opentrng/ptrng/hardware/config/registers/regmap.md

# PTRNG register map

Created with [Corsair](https://github.com/esynr3z/corsair) v1.0.4.

## Conventions

| Access mode | Description |
| :--- | :--- |
| rw | Read and Write |
| rw1c | Read and Write 1 to Clear |
| rw1s | Read and Write 1 to Set |
| ro | Read Only |
| roc | Read Only to Clear |
| roll | Read Only / Latch Low |
| rolh | Read Only / Latch High |
| wo | Write only |
| wosc | Write Only / Self Clear |

## Register map summary

Base address: 0x00000000

| Name | Address | Description |
| :--- | :--- | :--- |
| [ID](#id) | 0x0000 | OpenTRNG's PTRNG identification register for UID and revision number. |
| [CONTROL](#control) | 0x0004 | Global control register for the OpenTRNG's PTRNG |
| [ANALOG](#analog) | 0x0008 | Control register for analog measurements (temperature and voltage) |
| [RING](#ring) | 0x000c | Ring-oscillator enable register (enable bits are active at '1') |
| [FREQCTRL](#freqctrl) | 0x0010 | Frequency counter control register |
| [FREQVALUE](#freqvalue)  | 0x0014 | Frequency counter register for reading the measured value |
| [FREQDIVIDER](#freqdivider) | 0x0018 | Clock divider register, applies on oscillator RO0 |
| [MONITORING](#monitoring) | 0x001c | Register for monitoring the total failure alarm and the online tests |
| [ALARM](#alarm) | 0x0020 | Register for configuring the total failure alarm |
| [ONLINETEST](#onlinetest) | 0x0024 | Register for configuring the online test |
| [FIFOCTRL](#fifoctrl) | 0x0028 | Control register for the FIFO, into read the PTRNG random data output |
| [FIFODATA](#fifodata) | 0x002c | Data register for the FIFO to read the PTRNG random data output |

## ID

OpenTRNG's PTRNG identification register for UID and revision number.

Address offset: 0x0000

Reset value: 0x0001cea3

| Name | Bits | Mode | Reset | Description |
| :--- | :--- | :--- | :--- | :--- |
| REV | 31:16  | ro | 0x0001 | Revision number |
| UID | 15:0 | ro | 0xcea3 | Unique ID for OpenTRNG's PTRNG |

Back to [Register map](#register-map-summary).

## CONTROL

Global control register for the OpenTRNG's PTRNG

Address offset: 0x0004

Reset value: 0x00000000

| Name | Bits | Mode | Reset | Description |
| :--- | :--- | :--- | :--- | :--- |
| - | 31:2 | - | 0x0000000  | Reserved |
| CONDITIONING | 1 | rw | 0x0 | Enable or disable the algorithmic post processing to convert RRN to IRN active to '1', bypass at '0' |
| RESET | 0 | wosc | 0x0 | Synchronous reset active to '1' |

Back to [Register map](#register-map-summary).

## ANALOG

Control register for analog measurements (temperature and voltage)

Address offset: 0x0008

Reset value: 0x00000000

| Name | Bits | Mode | Reset | Description |
| :--- | :--- | :--- | :--- | :--- |
| EN | 31 | rw | 0x0 | Enable continuous temperature and voltage measurements |
| - | 30:24  | - | 0x0 | Reserved |
| VOLTAGE | 23:12  | ro | 0x000 | Measured voltage |
| TEMPERATURE | 11:0 | ro | 0x000 | Measured temperature |

Back to [Register map](#register-map-summary).

## RING

Ring-oscillator enable register (enable bits are active at '1')

Address offset: 0x000c

Reset value: 0x00000000

| Name | Bits | Mode | Reset | Description |
| :--- | :--- | :--- | :--- | :--- |
| EN | 31:0 | rw | 0x00000000 | The bit at index _i_ in the bitfield enables the RO number _i_ |

Back to [Register map](#register-map-summary).

## FREQCTRL

Frequency counter control register

Address offset: 0x0010

Reset value: 0x00000000

| Name | Bits | Mode | Reset | Description |
| :--- | :--- | :--- | :--- | :--- |
| OVERFLOW | 31 | ro | 0x0 | Flag set to '1' if an overflow occurred during measurement |
| - | 30:8 | - | 0x00000 | Reserved |
| SELECT | 7:3 | rw | 0x0 | Select the index of the ring-oscillator for frequency measurement |
| DONE | 2 | ro | 0x0 | This field is set to '1' when the measure is done and ready to be read |
| START | 1 | wosc | 0x0 | Write '1' to start the frequency counter measure |
| EN | 0 | rw | 0x0 | Enable the frequency counter (active at '1') |

Back to [Register map](#register-map-summary).

## FREQVALUE

Frequency counter register for reading the measured value

Address offset: 0x0014

Reset value: 0x00000000

| Name | Bits | Mode | Reset | Description |
| :--- | :--- | :--- | :--- | :--- |
| VALUE | 31:0 | ro | 0x00000000 | Measured value (unit in cycles of the system clock) |

Back to [Register map](#register-map-summary).

## FREQDIVIDER

Clock divider register, applies on oscillator RO0

Address offset: 0x0018

Reset value: 0x00000000

| Name | Bits | Mode | Reset | Description |
| :--- | :--- | :--- | :--- | :--- |
| VALUE | 31:0 | rw | 0x00000000 | Clock divider value (1 means no division, 2 division by two, ...) |

Back to [Register map](#register-map-summary).

## MONITORING

Register for monitoring the total failure alarm and the online tests

Address offset: 0x001c

Reset value: 0x00000000

| Name | Bits | Mode | Reset | Description |
| :--- | :--- | :--- | :--- | :--- |
| - | 31:3 | - | 0x0000000  | Reserved |
| CLEAR | 2 | wosc | 0x0 | This signal clears the online test to set the 'valid' signal back to '1' |
| VALID | 1 | ro | 0x0 | This signal is set to '1' when the online test is valid, when it falls to '0' (invalid) it must be manually cleared |
| ALARM | 0 | roc | 0x0 | This signal is triggered to '1' in the event of a total failure alarm, the alarm is cleared on PTRNG reset only |

Back to [Register map](#register-map-summary).

## ALARM

Register for configuring the total failure alarm

Address offset: 0x0020

Reset value: 0x00000000

| Name | Bits | Mode | Reset | Description |
| :--- | :--- | :--- | :--- | :--- |
| THRESHOLD | 31:0 | rw | 0x00000000 | Threshold value for triggering the total failure alarm. The threshold is compared to a counter and the alarm is triggered when the counter becomes greater or equal than the threshold. The counting method depends on the digitizer type (ERO, MURO, COSO...) |

Back to [Register map](#register-map-summary).

## ONLINETEST

Register for configuring the online test

Address offset: 0x0024

Reset value: 0x00000000

| Name | Bits | Mode | Reset | Description |
| :--- | :--- | :--- | :--- | :--- |
| DEVIATION | 31:16  | rw | 0x0000 | Maximum difference between the average expected value and the current internal value for the online test |
| AVERAGE | 15:0 | rw | 0x0000 | Average expected value for the online test internal value |

Back to [Register map](#register-map-summary).

## FIFOCTRL

Control register for the FIFO, into read the PTRNG random data output

Address offset: 0x0028

Reset value: 0x00000000

| Name | Bits | Mode | Reset | Description |
| :--- | :--- | :--- | :--- | :--- |
| - | 31:23  | - | 0x00 | Reserved |
| BURSTSIZE | 22:7 | ro | 0x0000 | Size of a burst (in count of 32bit words) |
| RDBURSTAVAILABLE | 6 | ro | 0x0 | Valid to '1' when a burst is available for read (see BURSTSIZE) |
| ALMOSTFULL | 5 | ro | 0x0 | Almost full flag |
| ALMOSTEMPTY | 4 | ro | 0x0 | Almost empty flag |
| FULL | 3 | ro | 0x0 | Full flag |
| EMPTY | 2 | ro | 0x0 | Empty flag |
| NOPACKING | 1 | rw | 0x0 | When packing is disabled IRN as written as 32-bit words in the FIFO instead of packing their LSB into 32-bit words |
| CLEAR | 0 | wosc | 0x0 | Clear the FIFO |

Back to [Register map](#register-map-summary).

## FIFODATA

Data register for the FIFO to read the PTRNG random data output

Address offset: 0x002c

Reset value: 0x00000000

| Name | Bits | Mode | Reset | Description |
| :--- | :--- | :--- | :--- | :--- |
| DATA | 31:0 | ro | 0x00000000 | 32 bits word from the PTRNG |

Back to [Register map](#register-map-summary).
