opentrng/ptrng/doc/img/coso.png

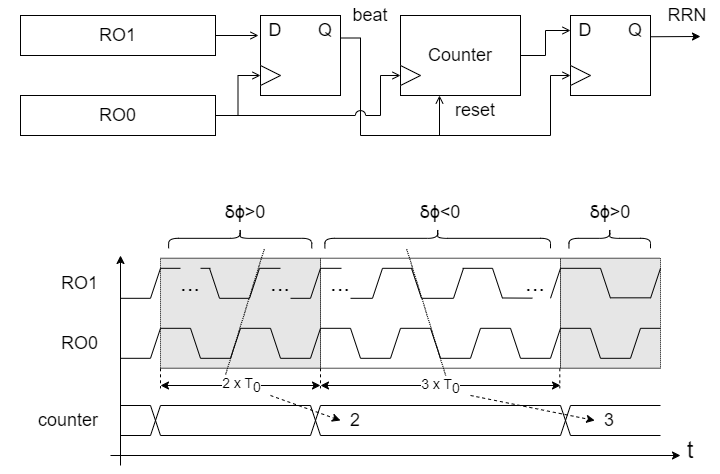
doc/img/coso.png
