opentrng/ptrng/doc/img/ero.png

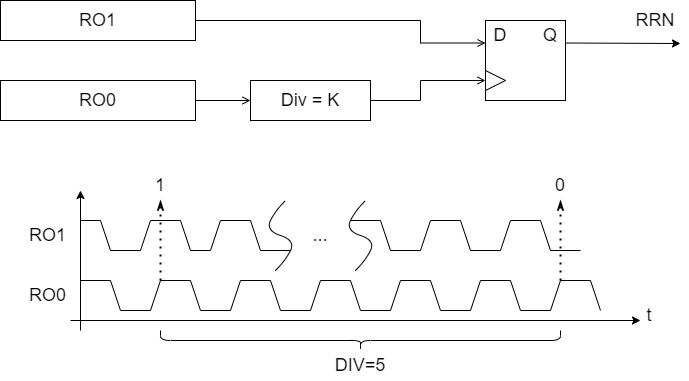
doc/img/ero.png
