opentrng/ptrng/doc/img/muro.png

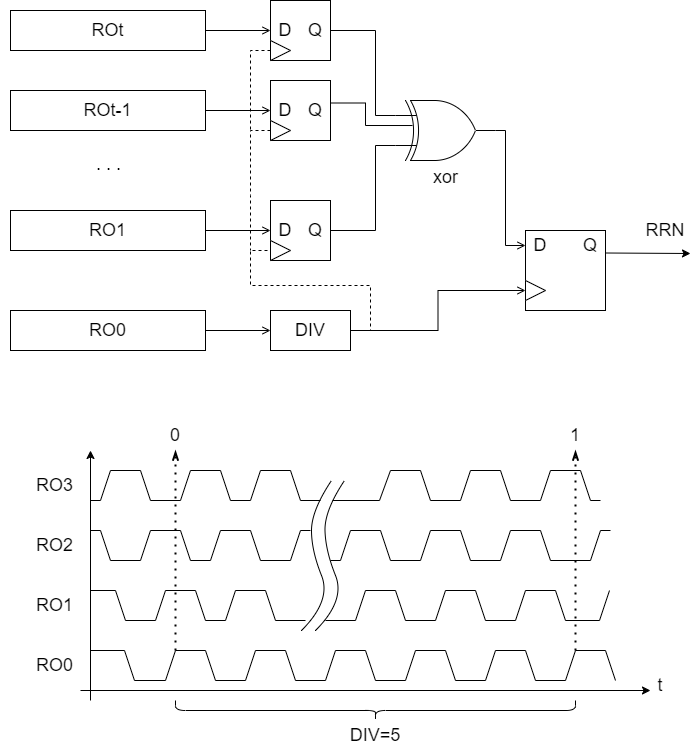
doc/img/muro.png
