opentrng/ptrng/doc/img/ptrng.png

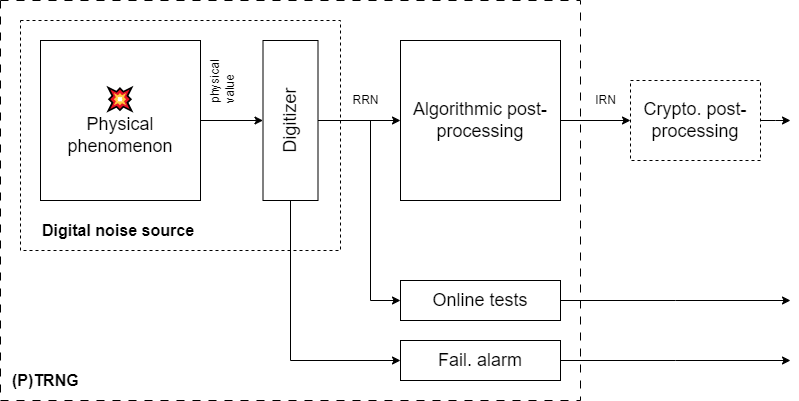
doc/img/ptrng.png
