opentrng/ptrng/doc/img/ringo.png

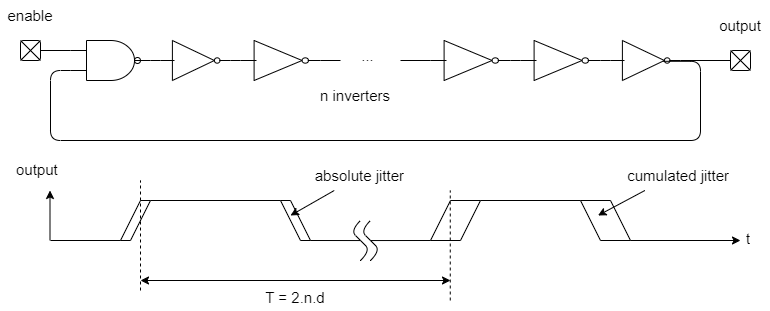
doc/img/ringo.png
