opentrng/ptrng/doc/img/simulation.png

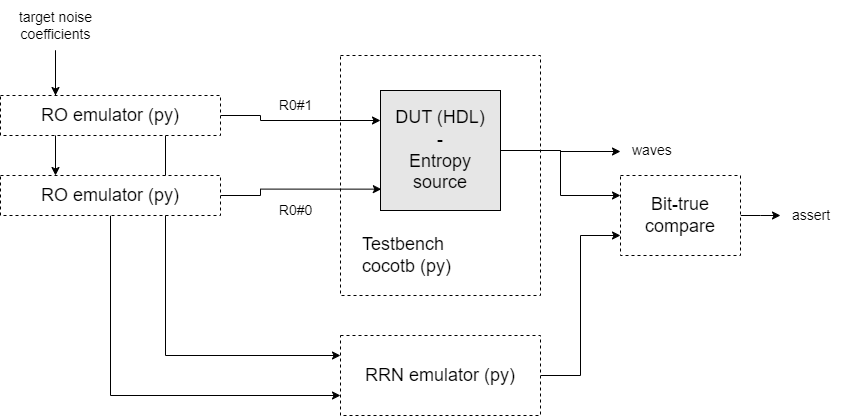
doc/img/simulation.png
