opentrng/ptrng/doc/img/workflow.png

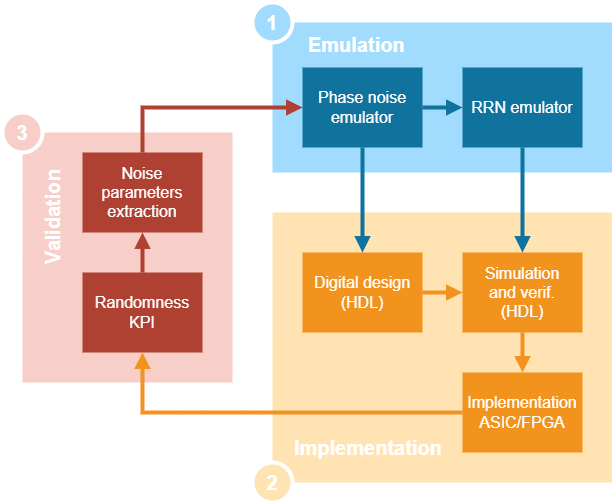
doc/img/workflow.png
