opentrng/ptrng/hardware/config/registers/regmap.yaml

regmap:
-   name: ID
    description: OpenTRNG's PTRNG identification register for UID and revision number.
    address: 0
    bitfields:
    -   name: UID
        description: Unique ID for OpenTRNG's PTRNG
        reset: 0xCEA3
        width: 16
        lsb: 0
        access: ro
        hardware: f
    -   name: REV
        description: Revision number
        reset: 1
        width: 16
        lsb: 16
        access: ro
        hardware: f
-   name: CONTROL
    description: Global control register for the OpenTRNG's PTRNG
    bitfields:
    -   name: RESET
        description: Synchronous reset active to '1'
        width: 1
        lsb: 0
        access: wosc
        hardware: o
    -   name: CONDITIONING
        description: Enable or disable the algorithmic post processing to convert RRN to IRN active to '1', bypass at '0'
        width: 1
        lsb: 1
        access: rw
        hardware: o
-   name: ANALOG
    description: Control register for analog measurements (temperature and voltage)
    bitfields:
    -   name: TEMPERATURE
        description: Measured temperature
        width: 12
        lsb: 0
        access: ro
        hardware: i
    -   name: VOLTAGE
        description: Measured voltage
        width: 12
        lsb: 12
        access: ro
        hardware: i
    -   name: EN
        description: Enable continuous temperature and voltage measurements
        width: 1
        lsb: 31
        access: rw
        hardware: o
-   name: RING
    description: Ring-oscillator enable register (enable bits are active at '1')
    bitfields:
    -   name: EN
        description: The bit at index _i_ in the bitfield enables the RO number _i_
        width: 32
        lsb: 0
        access: rw
        hardware: o
-   name: FREQCTRL
    description: Frequency counter control register
    bitfields:
    -   name: EN
        description: Enable the frequency counter (active at '1')
        width: 1
        lsb: 0
        access: rw
        hardware: o
    -   name: START
        description: Write '1' to start the frequency counter measure
        width: 1
        lsb: 1
        access: wosc
        hardware: o
    -   name: DONE
        description: This field is set to '1' when the measure is done and ready to be read
        width: 1
        lsb: 2
        access: ro
        hardware: i
    -   name: SELECT
        description: Select the index of the ring-oscillator for frequency measurement
        width: 5
        lsb: 3
        access: rw
        hardware: o
    -   name: OVERFLOW
        description: Flag set to '1' if an overflow occurred during measurement
        width: 1
        lsb: 31
        access: ro
        hardware: i
-   name: FREQVALUE
    description: Frequency counter register for reading the measured value
    bitfields:
    -   name: VALUE
        description: Measured value (unit in cycles of the system clock)
        width: 32
        lsb: 0
        access: ro
        hardware: i
-   name: FREQDIVIDER
    description: Clock divider register, applies on oscillator RO0
    bitfields:
    -   name: VALUE
        description: Clock divider value (1 means no division, 2 division by two, ...)
        width: 32
        lsb: 0
        access: rw
        hardware: oa
-   name: MONITORING
    description: Register for monitoring the total failure alarm and the online tests
    bitfields:
    -   name: ALARM
        description: This signal is triggered to '1' in the event of a total failure alarm, the alarm is cleared on PTRNG reset only
        width: 1
        lsb: 0
        access: roc
        hardware: i
    -   name: VALID
        description: This signal is set to '1' when the online test is valid, when it falls to '0' (invalid) it must be manually cleared
        width: 1
        lsb: 1
        access: ro
        hardware: i
    -   name: CLEAR
        description: This signal clears the online test to set the 'valid' signal back to '1'
        width: 1
        lsb: 2
        access: wosc
        hardware: o
-   name: ALARM
    description: Register for configuring the total failure alarm
    bitfields:
    -   name: THRESHOLD
        description: Threshold value for triggering the total failure alarm. The threshold is compared to a counter and the alarm is triggered when the counter becomes greater or equal than the threshold. The counting method depends on the digitizer type (ERO, MURO, COSO...)
        width: 32
        lsb: 0
        access: rw
        hardware: o
-   name: ONLINETEST
    description: Register for configuring the online test
    bitfields:
    -   name: AVERAGE
        description: Average expected value for the online test internal value
        width: 16
        lsb: 0
        access: rw
        hardware: o
    -   name: DEVIATION
        description: Maximum difference between the average expected value and the current internal value for the online test
        width: 16
        lsb: 16
        access: rw
        hardware: o
-   name: FIFOCTRL
    description: Control register for the FIFO, into read the PTRNG random data output
    bitfields:
    -   name: CLEAR
        description: Clear the FIFO
        width: 1
        lsb: 0
        access: wosc
        hardware: o
    -   name: NOPACKING
        description: When packing is disabled IRN as written as 32-bit words in the FIFO instead of packing their LSB into 32-bit words
        width: 1
        lsb: 1
        access: rw
        hardware: o
    -   name: EMPTY
        description: Empty flag
        width: 1
        lsb: 2
        access: ro
        hardware: i
    -   name: FULL
        description: Full flag
        width: 1
        lsb: 3
        access: ro
        hardware: i
    -   name: ALMOSTEMPTY
        description: Almost empty flag
        width: 1
        lsb: 4
        access: ro
        hardware: i
    -   name: ALMOSTFULL
        description: Almost full flag
        width: 1
        lsb: 5
        access: ro
        hardware: i
    -   name: RDBURSTAVAILABLE
        description: Valid to '1' when a burst is available for read (see BURSTSIZE)
        width: 1
        lsb: 6
        access: ro
        hardware: i
    -   name: BURSTSIZE
        description: Size of a burst (in count of 32bit words)
        width: 16
        lsb: 7
        access: ro
        hardware: i
-   name: FIFODATA
    description: Data register for the FIFO to read the PTRNG random data output
    bitfields:
    -   name: DATA
        description: 32 bits word from the PTRNG
        width: 32
        lsb: 0
        access: ro
        hardware: q
