opentrng/ptrng/(commit log)

2023-09-08 Bugfix: rofile was generating 2x longer periods as expected
    [divider.vhd]
2023-12-19 Switching to ghdl as default simulator and generating waves
2024-01-30 Fixing imported libraries, improved comments, fixed generic index issues
    [clkdiv.vhd, murowrapper.vhd, test_muro.py]
2024-02-01 Bugfix in RO emulator: limiting precision to femtosecond aligned with HDL simulators
    [test_muro.py]
2024-02-09 Architecture refactoring for introducing the digital noise source, first template generated file
    [digitalnoise.vhd, generate.py, ptrng.vhd, registers.py, registers.vhd, registers.yaml, ring.vhd, top.vhd]
2024-02-09 Synthesis fixes, entity and port name refactoring (again)
    [digitalnoise.vhd, frequency.py, ptrng.vhd, regmap.py, regmap.vhd, regmap.yaml, ring.vhd, top.vhd]
2024-02-16 PR script now generate full constraints for manual placement of digital noise entity
    [digitalnoise.vhd, frequency.py, generate.py, ring.vhd]
2024-02-19 PR script now places glue (freq counter, cdc...) into a border around the reserved area
2024-02-19 Ring-oscillator length includes the NAND
    [generate.py, ring.vhd]
2024-02-19 Added digitizer constraints for PR, fixing DMZ area size bug
    [digitalnoise.vhd, generate.py]
2024-02-19 Removing warning message related to timing in the ROs and on UART pins
2024-02-23 Fix ring monitoring output with DONT_TOUCH to place it into ring pblock
    [digitalnoise.vhd, ring.vhd]
2024-02-23 Added option to fix LUT input pins for PR constraints generation script
    [generate.py]
2024-04-19 Bugfix: setting for bitpacking was never set
    [readrng.py]
2024-10-17 Adding the total failure alarm for ERO/MURO/COSO and associated test cases
    [alarm.vhd, ptrng.vhd, regmap.py, regmap.vhd, regmap.yaml, top.vhd]
2024-10-21 Fixing alarm testbench for COSO, renaming PTRNG signal to be consistent
    [alarm.vhd, onlinetest.vhd, ptrng.vhd]
2024-11-05 Fixing bug in VN encoder in binary mode
    [conditioner.vhd]
2025-01-08 Switched default noise coefficients from FD28 to Artix 7
2025-01-08 Filtering first period for hist plots (to remove initial phase difference)
2025-01-16 Using A7's board physical reset button, reducing tty timeout
2025-01-16 Adding reset signal to ERO (drill to clock divider)
2025-01-16 Adding reset signal to MURO (drill to clock divider)
    [murowrapper.vhd, test_muro.py]
2025-01-16 Adding reset signal to COSO
    [coso.vhd]
2025-01-16 Propagating divider access signal and reset through the digitizer
    [digitizer.vhd]
2025-01-16 Using the async reset for counter
    [freqcounter.vhd]
2025-01-16 Adding clear signal (acts as synchronous reset driven by SW reset)
    [digitalnoise.vhd, freqcounter.vhd, synchronizer.vhd]
2025-01-16 SW reset now handle the clear (synchronous) signal, reset is dedicated to HW async reset
    [alarm.vhd, bitpacker.vhd, conditioner.vhd, onlinetest.vhd, ptrng.vhd]
2025-01-16 Updated default parameters to generate ERO/MURO/COSO for the Arty7 board
2025-01-21 Removing reset signal for RO related signals in ERO/MURO/COSO to fit the model at best
    [coso.vhd, digitizer.vhd]
2025-02-04 Bugfix: removed division factor resync since it was not updated when input clock was OFF
    [clkdivider.vhd]
2025-02-04 Moving packer enable from packbits to nopacking to have a more secure behavior when reset (at '0')
    [frequency.py, ping.py, ptrng.vhd, readrng.py, regmap.py, regmap.vhd, regmap.yaml, top.vhd]
2025-02-17 Adding die temperature sensor
2025-02-21 Avoiding automatic latch insertion
    [alarm.vhd, analog.vhd, bitpacker.vhd, clkdivider.vhd, conditioner.vhd, onlinetest.vhd, ptrng.vhd, synchronizer.vhd]
2025-03-05 Simplifying frequency divider (and bugfix)
    [clkdivider.vhd, digitizer.vhd]
2025-03-05 Bugfix: unassigned vector slice as data input of FIFO
    [digitizer.vhd]
2025-03-10 Averaging ADC measured data (x16)
2025-03-11 Added python script to read die temperature
2025-03-28 Bugfix: division factor for freq measurement was not adapted to system clock
    [frequency.py]
2025-03-28 Added a quiet parameter to avoid FIFO full warning while reading data from TRNG
    [readrng.py]
2025-05-20 Fixed simulation bug in digitanoise testbench
    [digitalnoise_stub.vhd]
2025-05-21 Better reset distribution for clearing the synchronizer
    [digitalnoise.vhd, digitizer.vhd, ptrng.vhd, readrng.py, synchronizer.vhd, top.vhd]
2025-09-03 Updated FPGA flow according to ptrng file move
2026-03-26 Typo fix for Arty A7 100T board name
